lw1414/motor_logger/codes/refernces/motor logger lcd.txt

#include <U8g2lib.h>
#include <SPI.h>

#define ADC_U_PIN 4
#define ADC_V_PIN 5
#define ADC_W_PIN 6

#define BUTTON_PIN 16

#define KNOWN_RESISTOR 270.0
#define VREF 3.3

#define SAMPLE_INTERVAL 10
#define RECORD_TIME 5000

// LCD (CLK, MOSI, CS, RESET)
U8G2_ST7920_128X64_F_SW_SPI lcd(U8G2_R0, 12, 11, 10, 13);

// ===== 2 POINT CALIBRATION =====
#define CAL_R1_ACTUAL 10.0
#define CAL_R2_ACTUAL 82.0

#define CAL_R1_MEASURED 7.03
#define CAL_R2_MEASURED 74.53
// ===============================

float scale;
float offset;

float lastU = 0;
float lastV = 0;
float lastW = 0;

float readResistance(int pin) {

  int adcValue = 0;

  for (int i = 0; i < 10; i++) {
    adcValue += analogRead(pin);
  }

  adcValue /= 10;

  float voltage = adcValue * (VREF / 4095.0);

  if (voltage >= VREF - 0.01) return -1;

  float resistance = (voltage * KNOWN_RESISTOR) / (VREF - voltage);

  return resistance;
}

float calibrate(float measured) {
  return (measured * scale) + offset;
}

void showReadyScreen() {

  lcd.clearBuffer();

  lcd.setFont(u8g2_font_ncenB08_tr);

  lcd.drawStr(20,20,"Motor Tester");
  lcd.drawStr(10,40,"Press Button");
  lcd.drawStr(20,55,"To Start");

  lcd.sendBuffer();
}

void showStartScreen() {

  lcd.clearBuffer();

  lcd.setFont(u8g2_font_ncenB08_tr);

  lcd.drawStr(20,30,"Start Process");

  lcd.sendBuffer();
}

void showProcessing() {

  lcd.clearBuffer();

  lcd.setFont(u8g2_font_ncenB08_tr);

  lcd.drawStr(25,30,"Processing...");

  lcd.sendBuffer();
}

void showLastValues() {

  char buf[20];

  lcd.clearBuffer();

  lcd.setFont(u8g2_font_ncenB08_tr);

  lcd.drawStr(10,10,"Last Read");

  sprintf(buf,"U: %.2f",lastU);
  lcd.drawStr(10,30,buf);

  sprintf(buf,"V: %.2f",lastV);
  lcd.drawStr(10,45,buf);

  sprintf(buf,"W: %.2f",lastW);
  lcd.drawStr(10,60,buf);

  lcd.sendBuffer();
}

void setup() {

  Serial.begin(115200);

  analogReadResolution(12);
  analogSetAttenuation(ADC_11db);

  pinMode(BUTTON_PIN, INPUT_PULLUP);

  lcd.begin();

  // Compute calibration parameters
  scale = (CAL_R2_ACTUAL - CAL_R1_ACTUAL) /
          (CAL_R2_MEASURED - CAL_R1_MEASURED);

  offset = CAL_R1_ACTUAL - (scale * CAL_R1_MEASURED);

  Serial.println("Press IO16 button to start recording");

  showReadyScreen();
}

void loop() {

  if (digitalRead(BUTTON_PIN) == LOW) {

    delay(50);

    if (digitalRead(BUTTON_PIN) == LOW) {

      showStartScreen();
      delay(1000);

      showProcessing();

      Serial.println("timestamp,U1,V1,W1");

      unsigned long startTime = millis();
      unsigned long currentTime = 0;

      while (currentTime <= RECORD_TIME) {

        float u = readResistance(ADC_U_PIN);
        float v = readResistance(ADC_V_PIN);
        float w = readResistance(ADC_W_PIN);

        u = calibrate(u);
        v = calibrate(v);
        w = calibrate(w);

        lastU = u;
        lastV = v;
        lastW = w;

        Serial.print(currentTime);
        Serial.print(",");
        Serial.print(u, 2);
        Serial.print(",");
        Serial.print(v, 2);
        Serial.print(",");
        Serial.println(w, 2);

        delay(SAMPLE_INTERVAL);

        currentTime = millis() - startTime;
      }

      Serial.println("Done");

      showLastValues();

      while (digitalRead(BUTTON_PIN) == LOW) {
        delay(10);
      }

      delay(5000);

      showReadyScreen();
    }
  }
}
