lw1414/motor_logger/files docs/motor logger block diagram.png

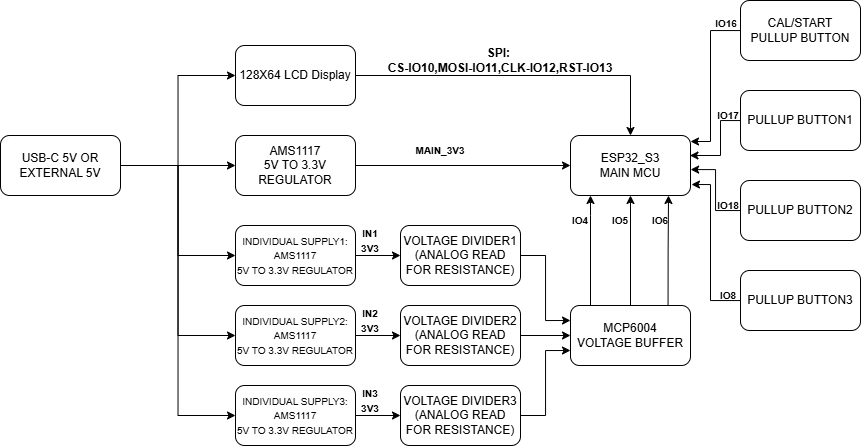
files docs/motor logger block diagram.png
