lw1414/motor_logger/files docs/motor logger flow chart.png

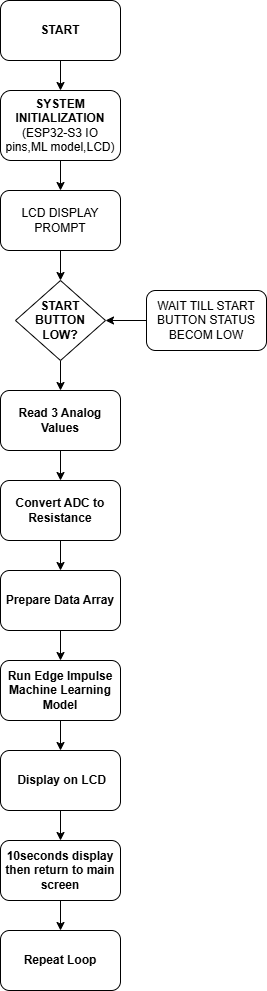
files docs/motor logger flow chart.png
