lw1414/motor_logger/files docs/python logging for data process.png

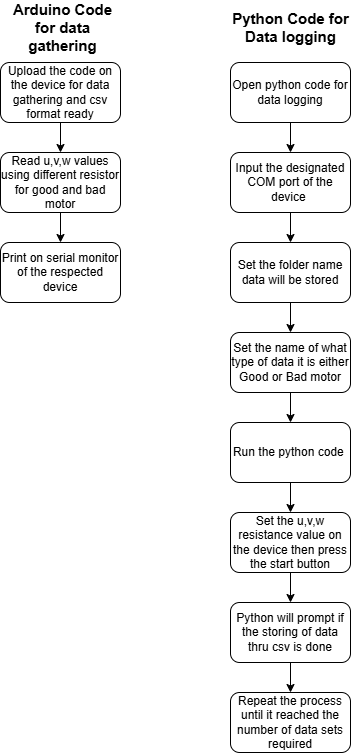
files docs/python logging for data process.png
