lw1414/motor_logger/motor-logger/3d/ESP32-S3-WROOM.step

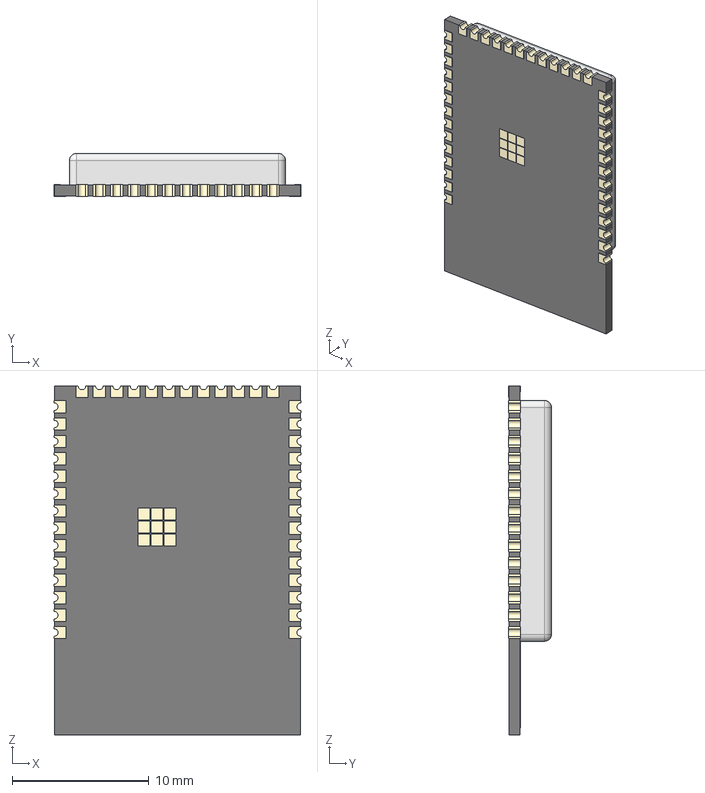
[picture p4: CAD file, 2026-02-25]
motor-logger/3d/ESP32-S3-WROOM.step
18.0 x 3.16 x 25.5 mm
ESP-S3-WROOM_via x 26
ESP32-S3-WROOM_shell
ESP32-S3-WROOM_body
ESP-S3-WROOM_via v3(镜像) x 14
