lw1414/motor_logger/motor-logger/3d/USB-C-SMD_TYPE-C16PIN.step

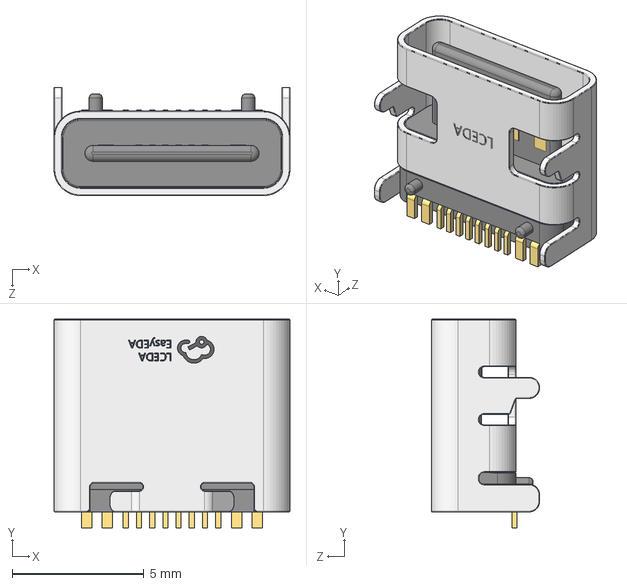
[picture p5: CAD file, 2026-02-25]
motor-logger/3d/USB-C-SMD_TYPE-C16PIN.step
8.94 x 7.90 x 4.10 mm
