lw1414/motor_logger/motor-logger/3d/LCD12864_st7920.step

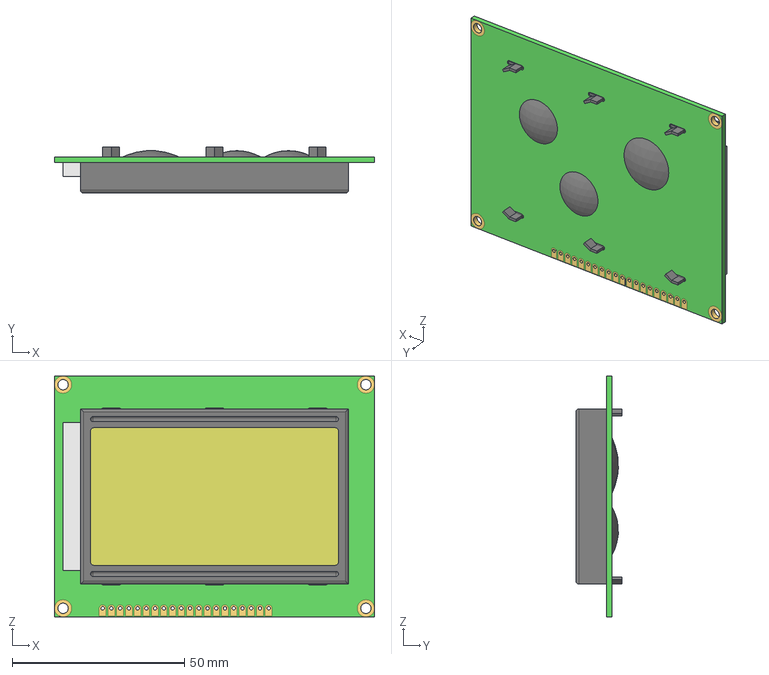
[picture p6: CAD file, 2026-02-25]
motor-logger/3d/LCD12864_st7920.step
93.0 x 13.5 x 70.0 mm
