lw1414/motor_logger/files docs/motor logger schematic.pdf

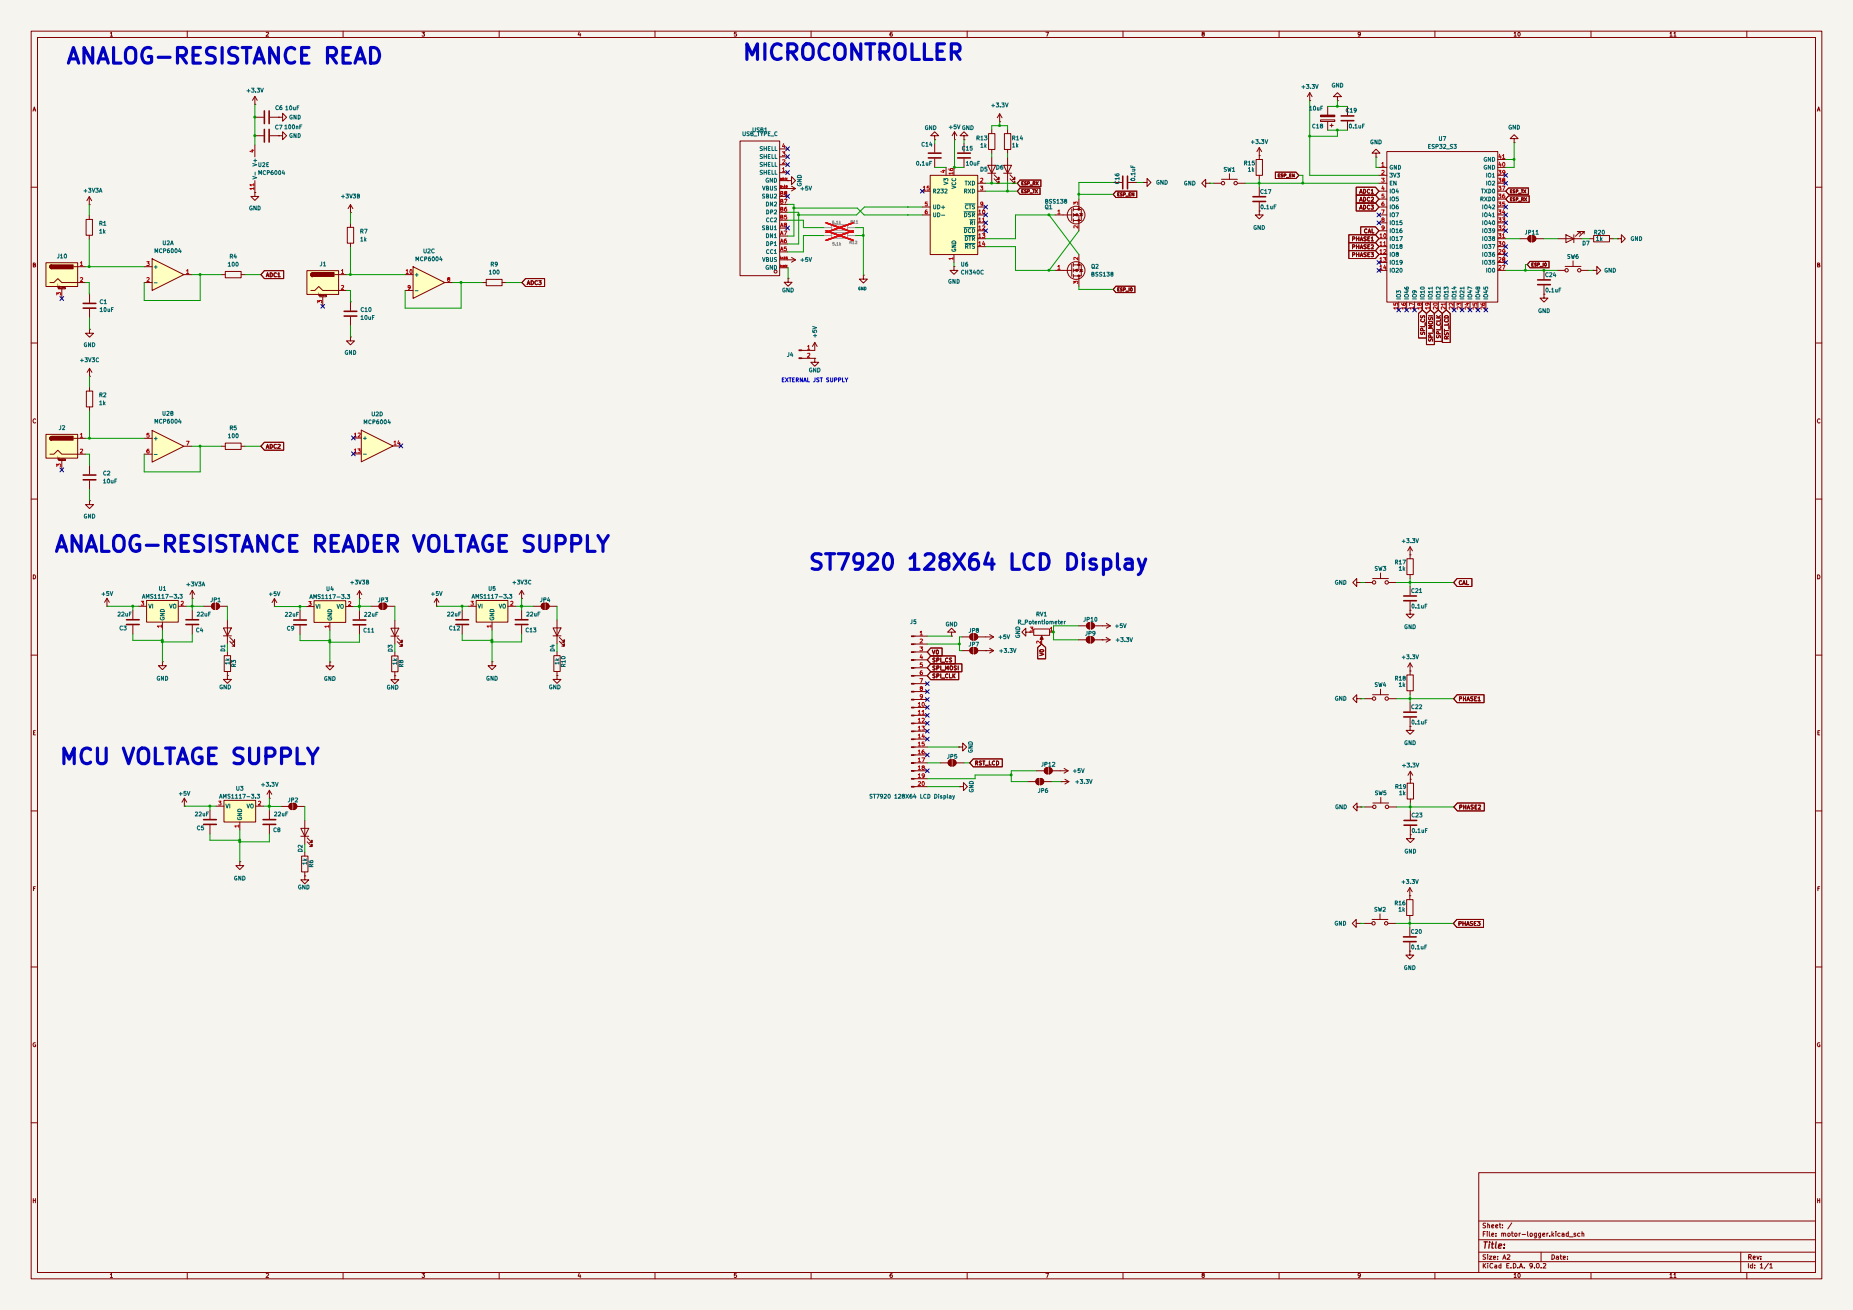
[picture p7: page 1]
