lw1414/motor_logger/motor-logger/motor-logger.kicad_pcb

## KiCad design motor-logger/motor-logger.kicad_pcb (2026-03-04)

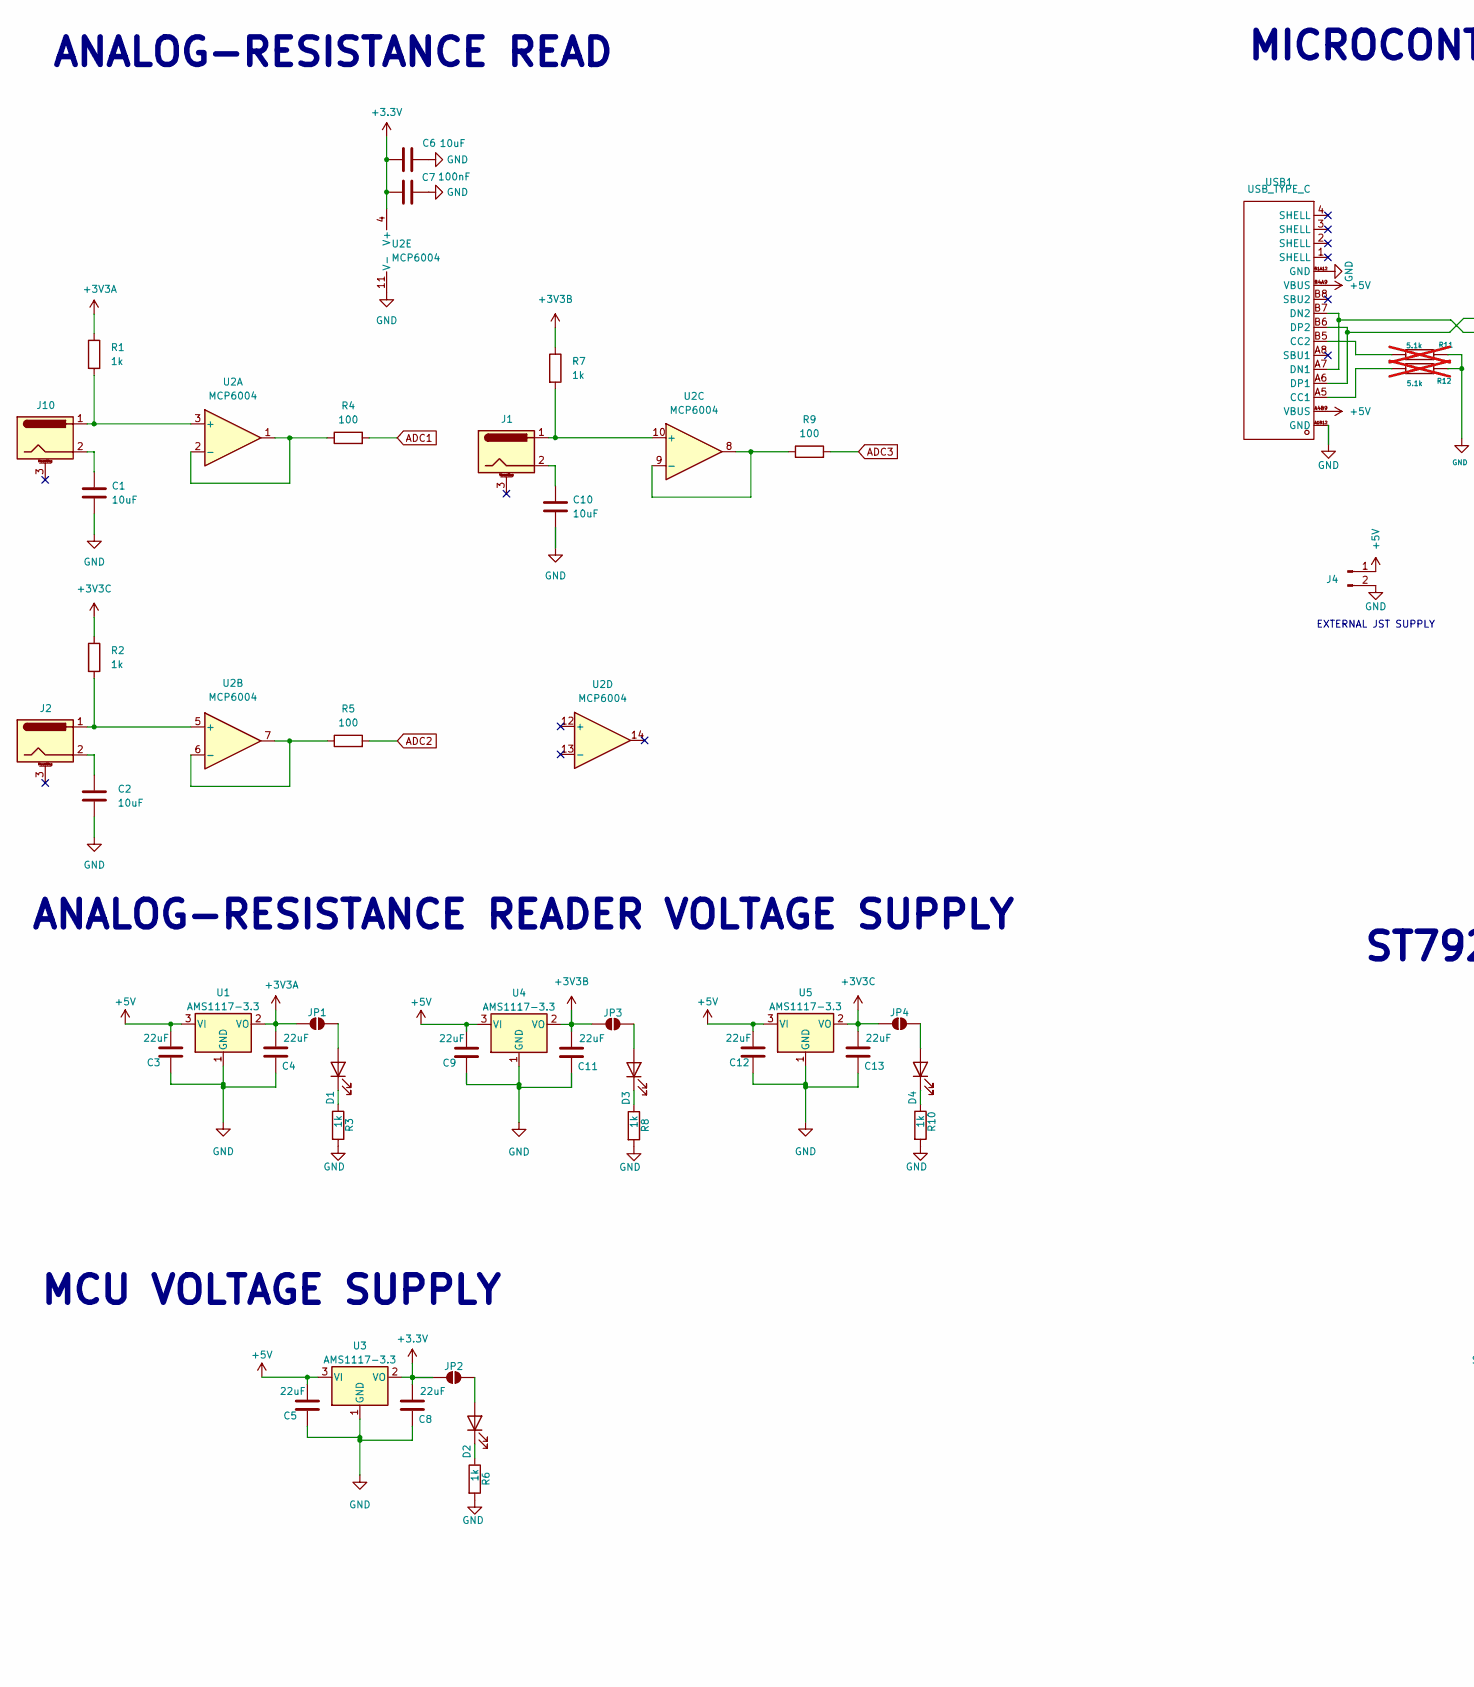
[picture p8: schematic motor-logger.kicad_sch, part in row 1, column 1]

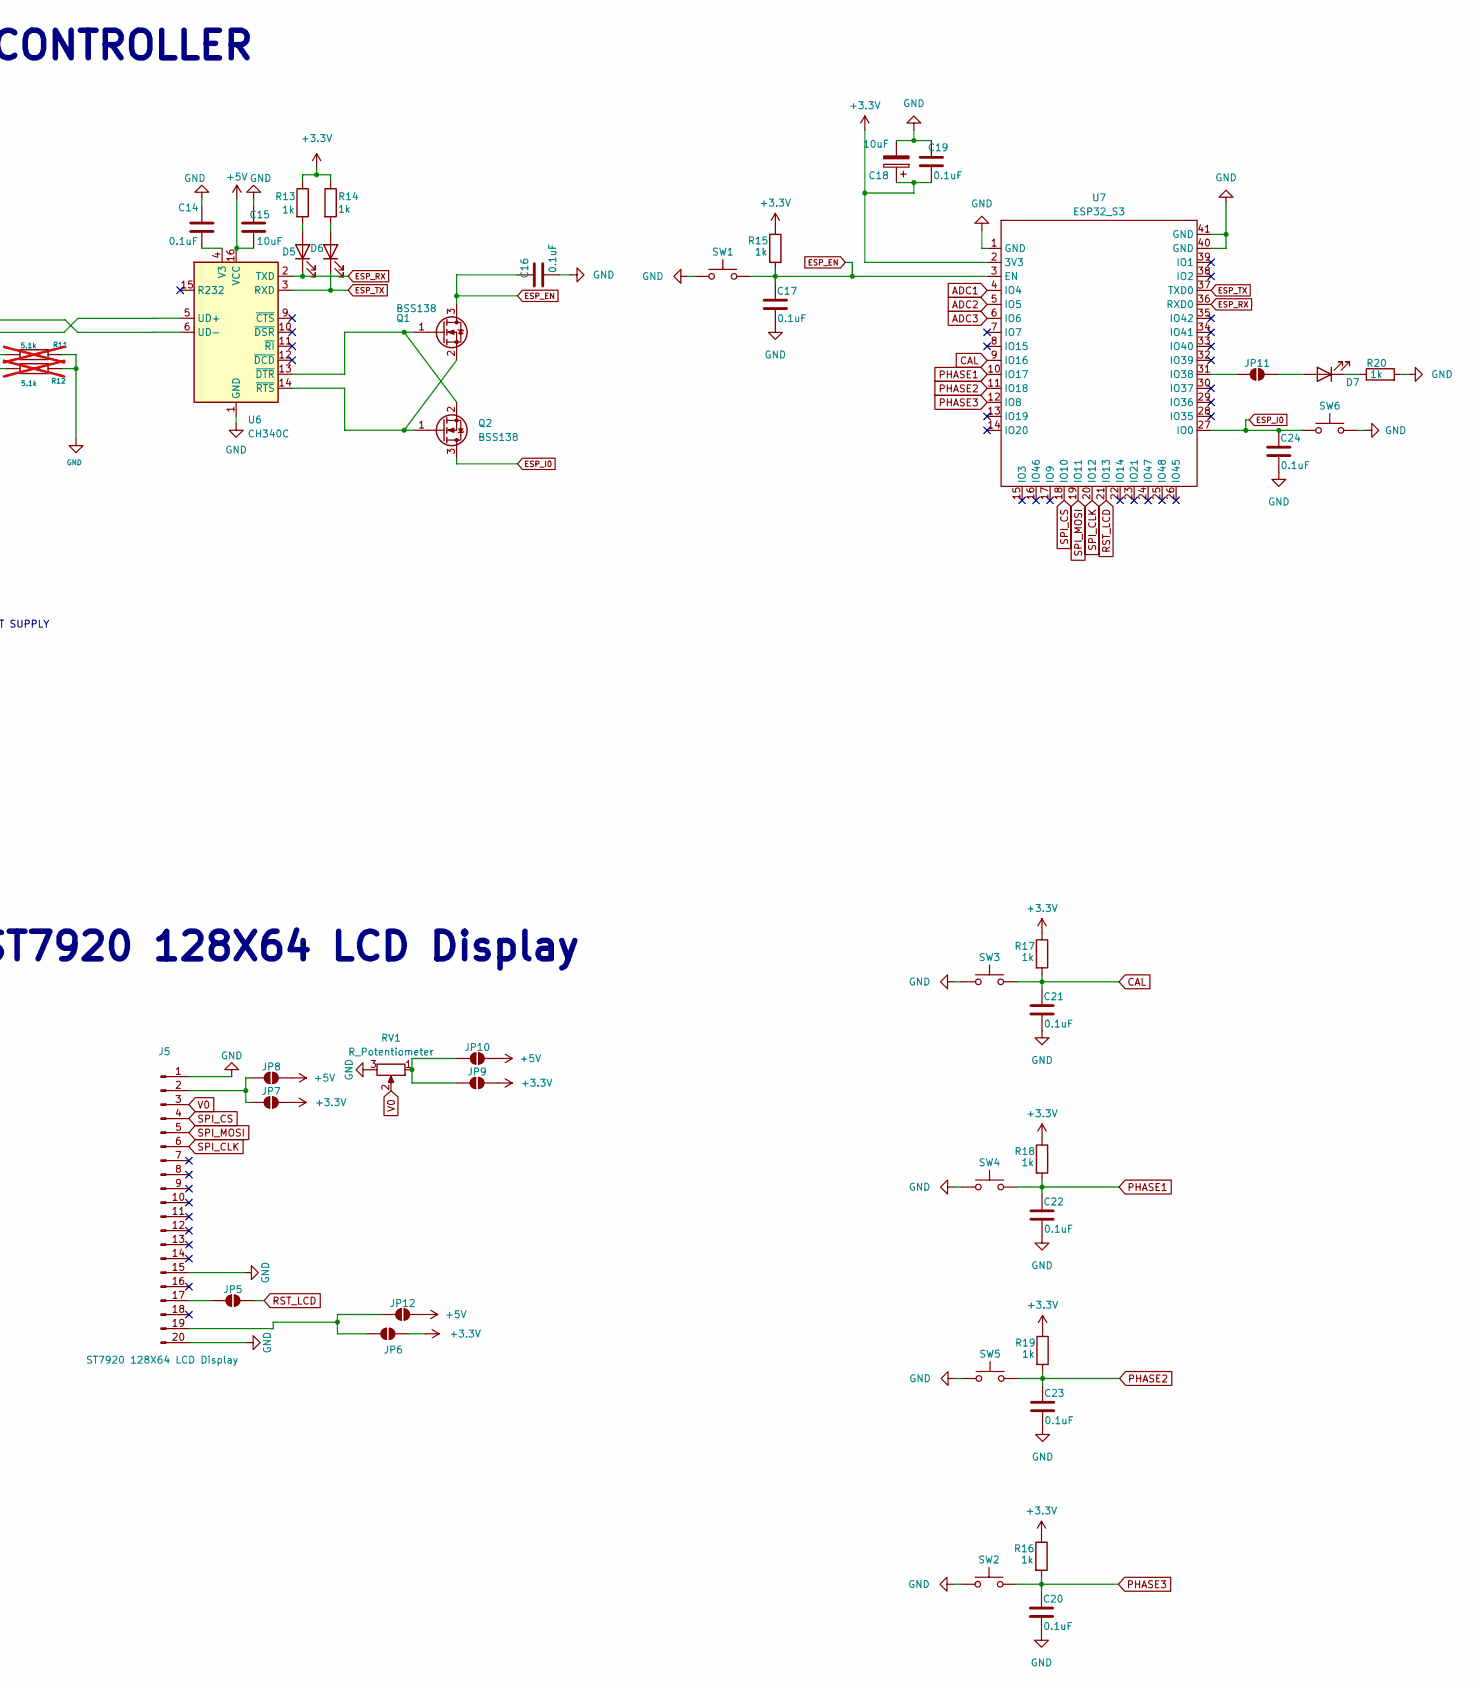
[picture p9: schematic motor-logger.kicad_sch, part in row 1, column 2]

Parts:
C1, C2, C6, C10, C15, C18: 10uF; C_0805_2012Metric_Pad1.18x1.45mm_HandSolder; LCSC C15850
C3, C4, C5, C8, C9, C11, C12, C13: 22uF; C_0603_1608Metric; LCSC C59461
C7: 100nF; C_0805_2012Metric_Pad1.18x1.45mm_HandSolder; LCSC C49678
C14, C16, C17, C19, C20, C21, C22, C23, C24: 0.1uF; C_0805_2012Metric_Pad1.18x1.45mm_HandSolder; LCSC C49678
D1, D2, D3, D4, D5, D6, D7: LED; LED_0805_2012Metric_Pad1.15x1.40mm_HandSolder; LCSC C2297
J1, J2, J10: Barrel_Jack_MountingPin; BarrelJack_GCT_DCJ200-10-A_Horizontal
J4: Conn_01x02_Pin; TerminalBlock_MaiXu_MX126-5.0-02P_1x02_P5.00mm
J5: ST7920 128X64 LCD Display; LCD-TH_HS12864-15C
JP1, JP2, JP3, JP4, JP5, JP6, JP7, JP8, JP9, JP10, JP11, JP12: SolderJumper_2_Open; SolderJumper-2_P1.3mm_Open_RoundedPad1.0x1.5mm
Q1, Q2: BSS138; SOT-23; LCSC C426569
R1, R2, R7: 1k; R_0805_2012Metric_Pad1.20x1.40mm_HandSolder; LCSC C21190
R3, R6, R8, R10, R13, R14, R15, R16, R17, R18, R19, R20: 1k; R_0603_1608Metric_Pad0.98x0.95mm_HandSolder; LCSC C21190
R4, R5, R9: 100; R_0805_2012Metric_Pad1.20x1.40mm_HandSolder; LCSC C105588
R11, R12: 5.1k; R_0603_1608Metric_Pad0.98x0.95mm_HandSolder; LCSC C103079; not fitted
RV1: R_Potentiometer; RES-ADJ-SMD_3P-L3.0-W3.8-P1.75-BR; LCSC C719176
SW1, SW6: SW_Push; SW_Tactile_SPST_NO_Straight_CK_PTS636Sx25SMTRLFS; LCSC C2689642
SW2, SW3, SW4, SW5: SW_Push; SW_PUSH_6mm_H9.5mm; LCSC C2689642
U1, U3, U4, U5: AMS1117-3.3; SOT-223-3_TabPin2; LCSC C5199435
U2: MCP6004; SOIC-14_3.9x8.7mm_P1.27mm; LCSC C7378
U6: CH340C; SOP-16_3.9x9.9mm_P1.27mm; LCSC C84681
U7: ESP32_S3; WIRELM-SMD_ESP32-S3-WROOM-1; Manufacturer Part ESP32-S3-WROOM-1-N16R2; LCSC Part Name 通用型Wi-Fi+低功耗蓝牙MCU模组
USB1: USB_TYPE_C; USB-C-SMD_TYPE-C16PIN; Manufacturer Part TYPE-C16PIN; LCSC Part Name Type-C 母 卧贴

Connections:
+3.3V: C6.1, C7.1, C8.2, C18.1, C19.1, JP2.1 (A), JP6.2 (B), JP7.2 (B), JP9.2 (B), R13.1, R14.1, R15.1, R16.1, R17.1, R18.1, R19.1, U2.4 (V+), U3.2 (VO), U7.2 (3V3)
+3V3A: C4.2, JP1.1 (A), R1.1, U1.2 (VO)
+3V3B: C11.2, JP3.1 (A), R7.1, U4.2 (VO)
+3V3C: C13.2, JP4.1 (A), R2.1, U5.2 (VO)
+5V: C3.2, C5.2, C9.2, C12.2, C15.1, J4.1, JP8.2 (B), JP10.2 (B), JP12.2 (B), U1.3 (VI), U3.3 (VI), U4.3 (VI), U5.3 (VI), U6.16 (VCC), USB1.A4B9 (VBUS), USB1.B4A9 (VBUS)
ADC1: R4.2, U7.4 (IO4)
ADC2: R5.2, U7.5 (IO5)
ADC3: R9.2, U7.6 (IO6)
CAL: C21.2, R17.2, SW3.2, U7.9 (IO16)
ESP_EN: C16.2, C17.2, Q1.3 (D), R15.2, SW1.2, U7.3 (EN)
ESP_I0: C24.2, Q2.3 (D), SW6.1, U7.27 (IO0)
ESP_RX: D5.1 (K), U6.2 (TXD), U7.36 (RXD0)
ESP_TX: D6.1 (K), U6.3 (RXD), U7.37 (TXD0)
GND: C1.2, C2.2, C3.1, C4.1, C5.1, C6.2, C7.2, C8.1, C9.1, C10.2, C11.1, C12.1, C13.1, C14.2, C15.2, C16.1, C17.1, C18.2, C19.2, C20.1, C21.1, C22.1, C23.1, C24.1, J4.2, J5.1, J5.15, J5.20, R3.2, R6.2, R8.2, R10.2, R11.2, R12.2, R20.2, RV1.3, SW1.1, SW2.1, SW3.1, SW4.1, SW5.1, SW6.2, U1.1 (GND), U2.11 (V-), U3.1 (GND), U4.1 (GND), U5.1 (GND), U6.1 (GND), U7.1 (GND), U7.40 (GND), U7.41 (GND), USB1.A1B12 (GND), USB1.B1A12 (GND)
unnamed: C1.1, J10.2
unnamed: C2.1, J2.2
unnamed: C10.1, J1.2
unnamed: D1.2 (A), JP1.2 (B)
unnamed: D1.1 (K), R3.1
unnamed: D2.2 (A), JP2.2 (B)
unnamed: D2.1 (K), R6.1
unnamed: D3.2 (A), JP3.2 (B)
unnamed: D3.1 (K), R8.1
unnamed: D4.2 (A), JP4.2 (B)
unnamed: D4.1 (K), R10.1
unnamed: D5.2 (A), R13.2
unnamed: D6.2 (A), R14.2
unnamed: D7.2 (A), JP11.2 (B)
unnamed: D7.1 (K), R20.1
unnamed: J5.2, JP7.1 (A), JP8.1 (A)
unnamed: J5.17, JP5.1 (A)
unnamed: J5.19, JP6.1 (A), JP12.1 (A)
unnamed: JP9.1 (A), JP10.1 (A), RV1.1
unnamed: JP11.1 (A), U7.31 (IO38)
unnamed: Q1.1 (G), Q2.2 (S), U6.13 (~DTR)
unnamed: Q1.2 (S), Q2.1 (G), U6.14 (~RTS)
unnamed: J10.1, R1.2, U2.3 (+)
unnamed: R4.1, U2.1, U2.2 (-)
unnamed: J2.1, R2.2, U2.5 (+)
unnamed: R5.1, U2.6 (-), U2.7
unnamed: J1.1, R7.2, U2.10 (+)
unnamed: R9.1, U2.8, U2.9 (-)
unnamed: U6.5 (UD+), USB1.A6 (DP1), USB1.B6 (DP2)
unnamed: U6.6 (UD-), USB1.A7 (DN1), USB1.B7 (DN2)
unnamed: C14.1, U6.4 (V3)
unnamed: R12.1, USB1.A5 (CC1)
unnamed: R11.1, USB1.B5 (CC2)
PHASE1: C22.2, R18.2, SW4.2, U7.10 (IO17)
PHASE2: C23.2, R19.2, SW5.2, U7.11 (IO18)
PHASE3: C20.2, R16.2, SW2.2, U7.12 (IO8)
RST_LCD: JP5.2 (B), U7.21 (IO13)
SPI_CLK: J5.6, U7.20 (IO12)
SPI_CS: J5.4, U7.18 (IO10)
SPI_MOSI: J5.5, U7.19 (IO11)
V0: J5.3, RV1.2

Notes on the sheet:
MCU VOLTAGE SUPPLY
MICROCONTROLLER
ANALOG-RESISTANCE READ
ST7920 128X64 LCD Display
EXTERNAL JST SUPPLY
ANALOG-RESISTANCE READER VOLTAGE SUPPLY

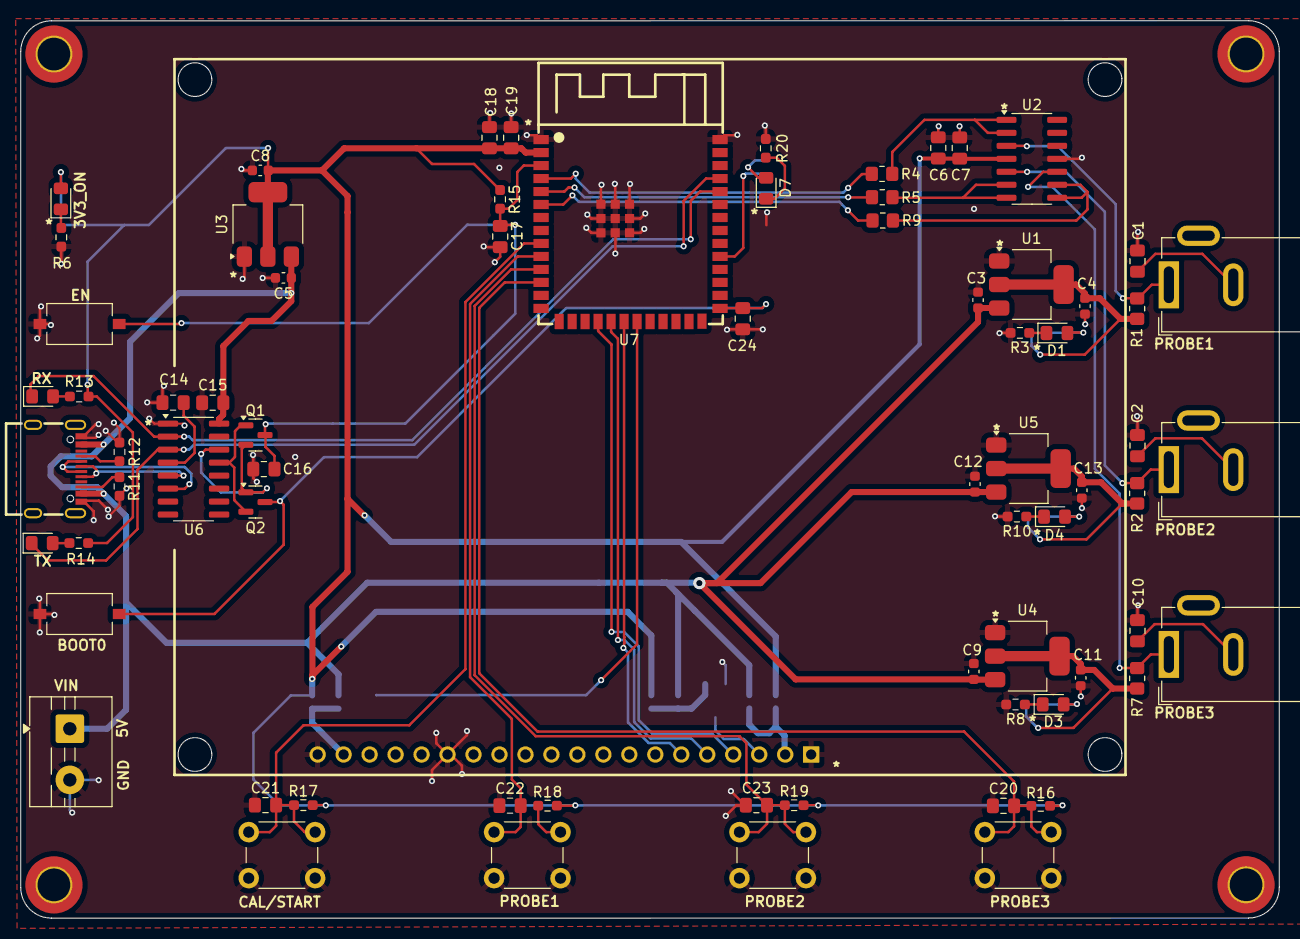
[picture p10: board motor-logger.kicad_pcb from above]

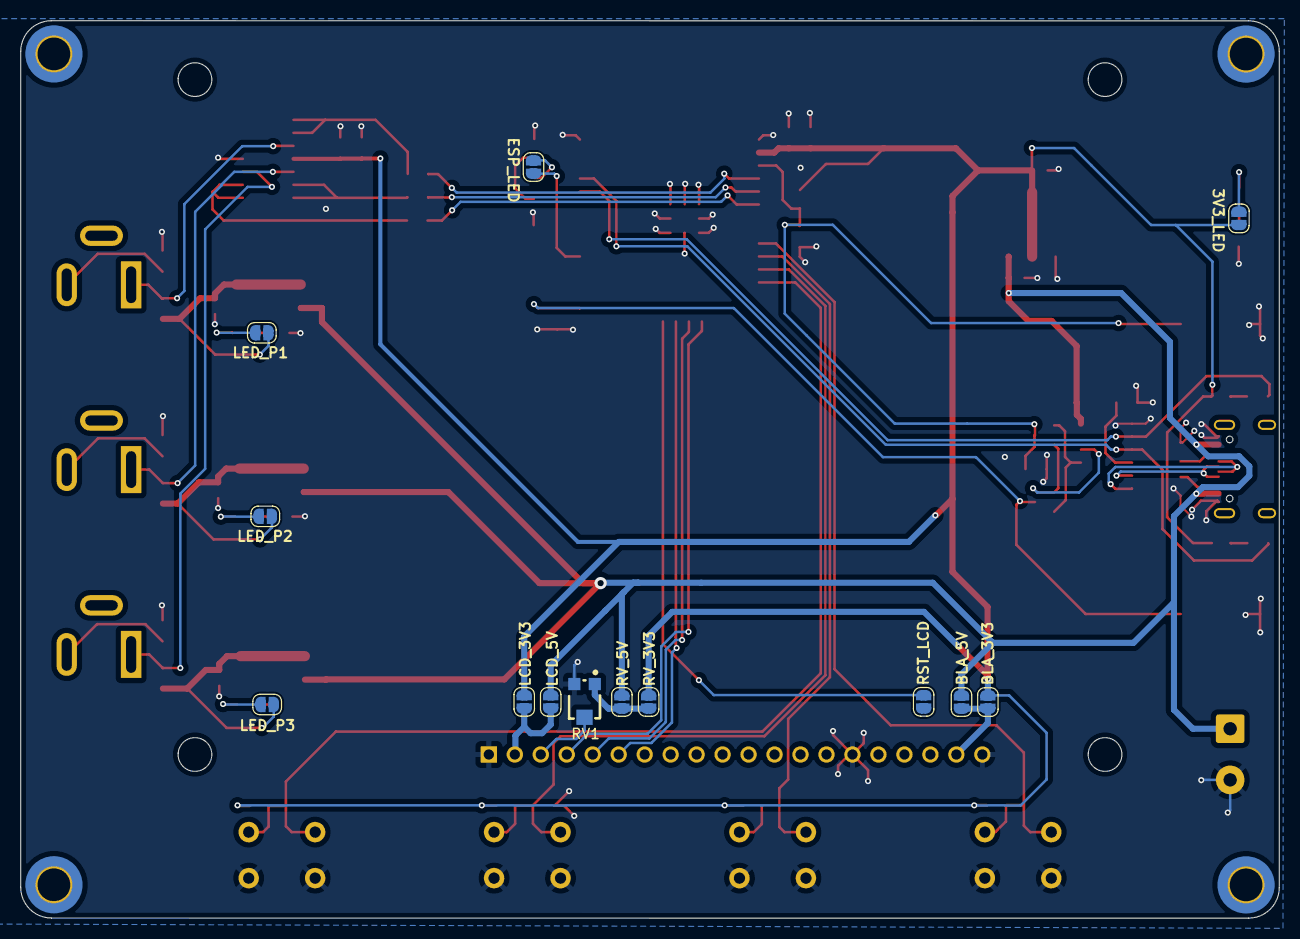
[picture p11: board motor-logger.kicad_pcb from below]

Board: 2 copper layers, 123.1 x 87.8 mm, 85 parts (13 on the bottom side), 55 nets.
